SashaBrooke/OhPossum/README.md

# OhPossum
Hardware for the "OhPossum" possum deterrent system.
