SashaBrooke/OhPossum/models/raspi_desktop_jig/initial-drawing.PNG

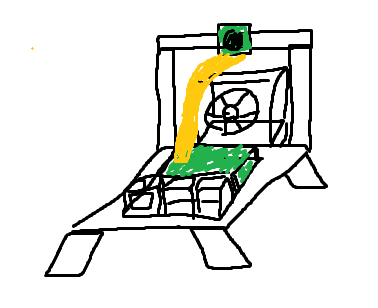
models/raspi_desktop_jig/initial-drawing.PNG
