SashaBrooke/OhPossum/models/motor_test_jig/motor_testing_assembly.rev1.SLDASM

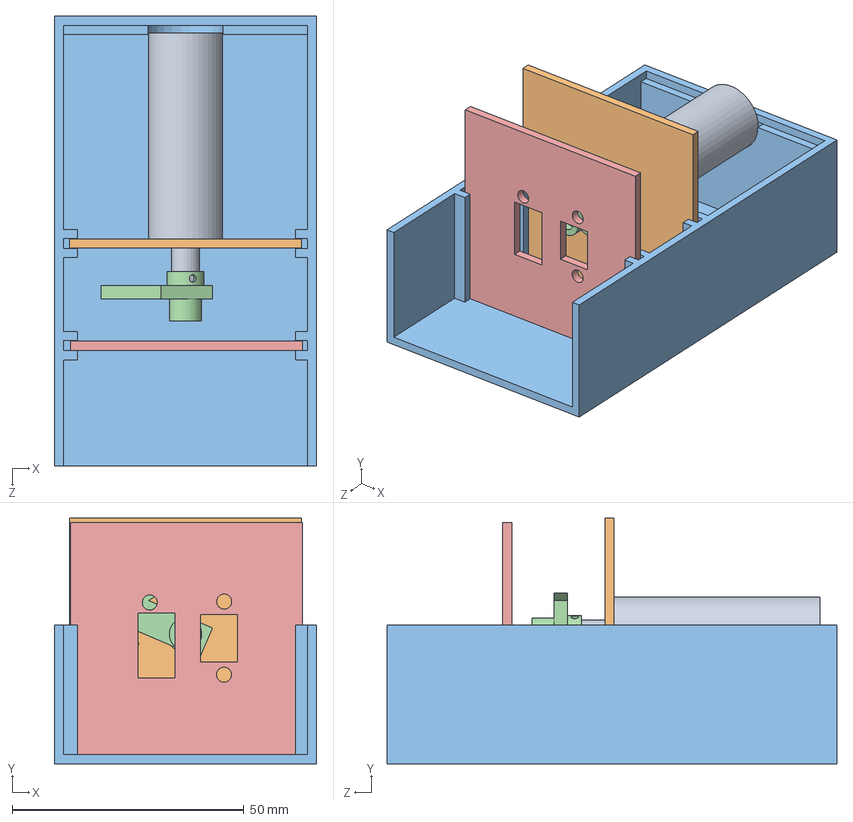
[picture p4: CAD file, 2025-03-11]
models/motor_test_jig/motor_testing_assembly.rev1.SLDASM
56.5 x 53.0 x 97.0 mm
Small Motor.rev1
Motor Mounting Plate.rev1
Motor Testing Base.rev1
Motor Testing Flag and Magnet Cap COMBO.rev3
Encoder Mounting Plate.rev2
