SashaBrooke/OhPossum/models/motor_test_jig/encoder_test_assem.rev2.SLDASM

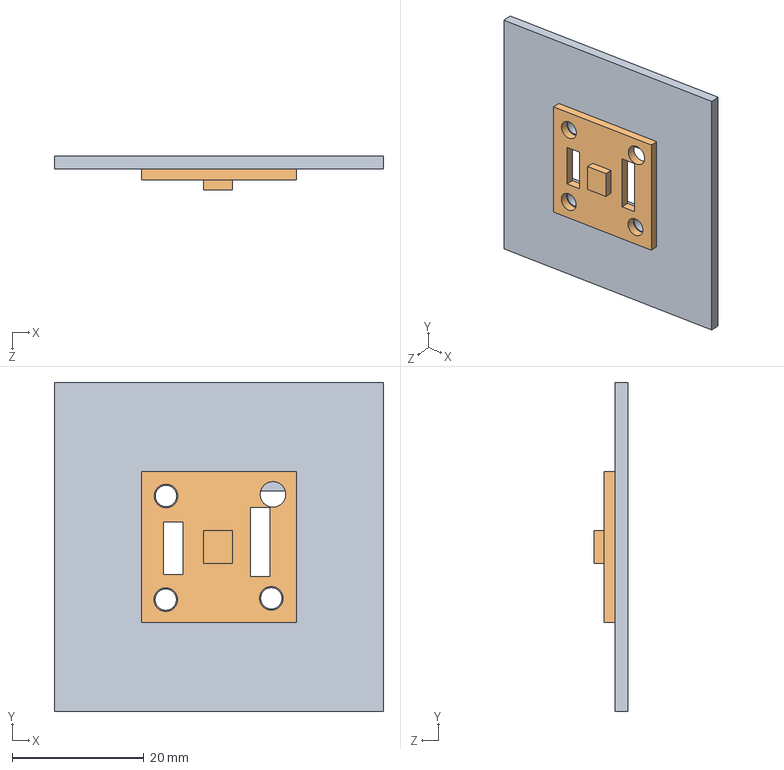
[picture p5: CAD file, 2025-03-11]
models/motor_test_jig/encoder_test_assem.rev2.SLDASM
50.0 x 50.0 x 5.20 mm
Encoder Mounting Plate.rev2
Ebay Encoder 1.rev1
