SashaBrooke/OhPossum/models/motor_test_jig/motor_mounting_plate.rev1.SLDPRT

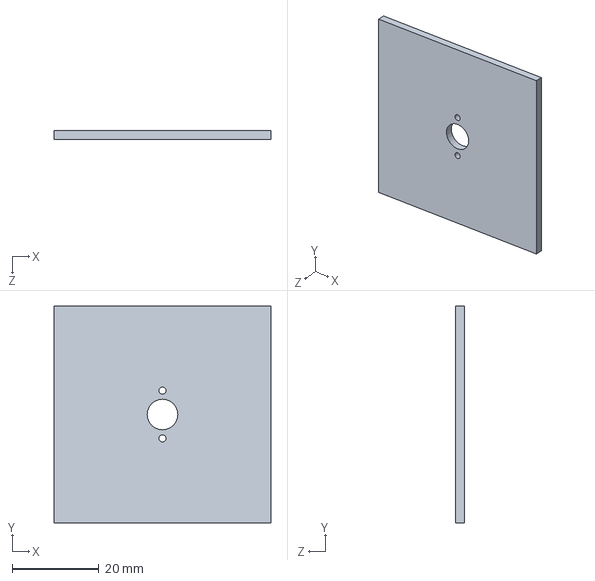
[picture p6: CAD file, 2025-03-11]
models/motor_test_jig/motor_mounting_plate.rev1.SLDPRT
50.0 x 50.0 x 2.00 mm
