SashaBrooke/OhPossum/models/motor_test_jig/motor_testing_base.rev1.SLDPRT

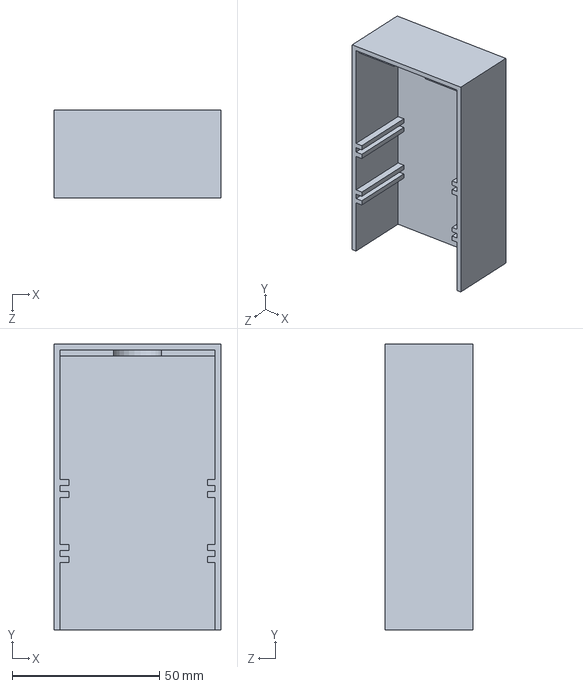
[picture p7: CAD file, 2025-03-11]
models/motor_test_jig/motor_testing_base.rev1.SLDPRT
56.5 x 97.0 x 30.0 mm
