SashaBrooke/OhPossum/models/prototype/v2/base.rev1.SLDPRT

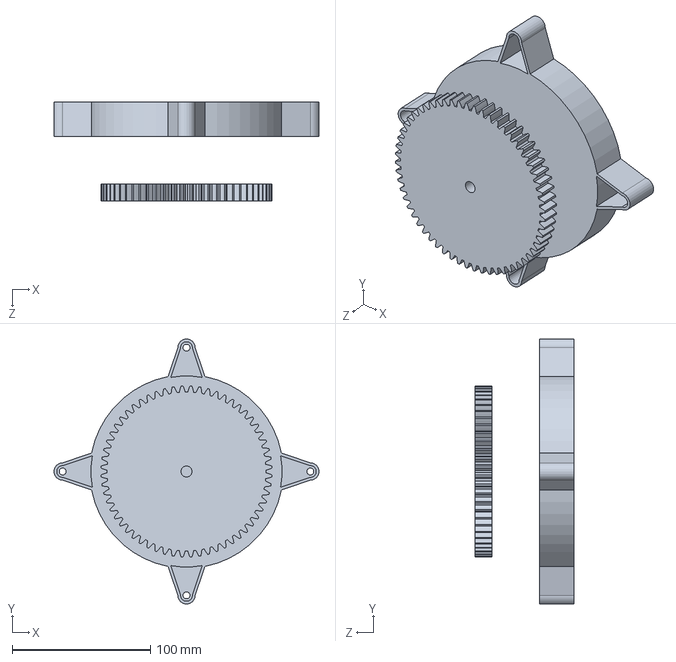
[picture p8: CAD file, 2025-03-11]
models/prototype/v2/base.rev1.SLDPRT
191.8 x 191.8 x 71.4 mm
