SashaBrooke/OhPossum/models/raspi_desktop_jig/raspberry_pi_desk_jig_model.SLDPRT

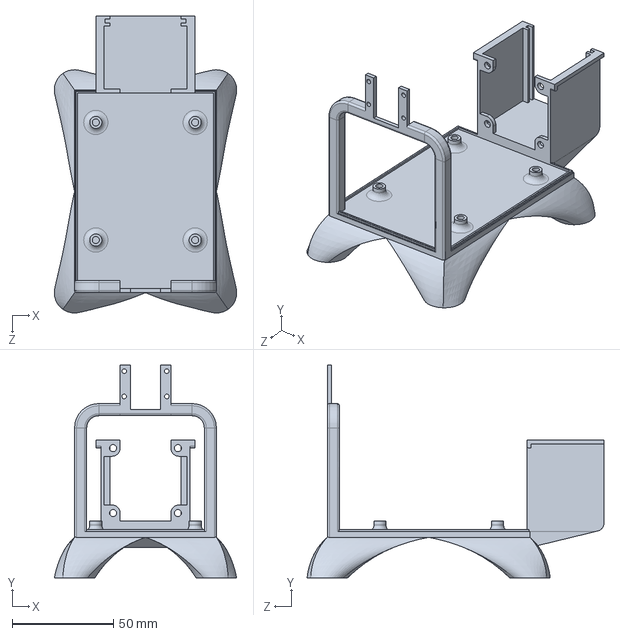
[picture p9: CAD file, 2025-05-20]
models/raspi_desktop_jig/raspberry_pi_desk_jig_model.SLDPRT
90.0 x 105.0 x 146.5 mm
