SashaBrooke/OhPossum/models/motor_test_jig/motor_testing_flag_and_magnet_cap_combo.rev3.SLDPRT

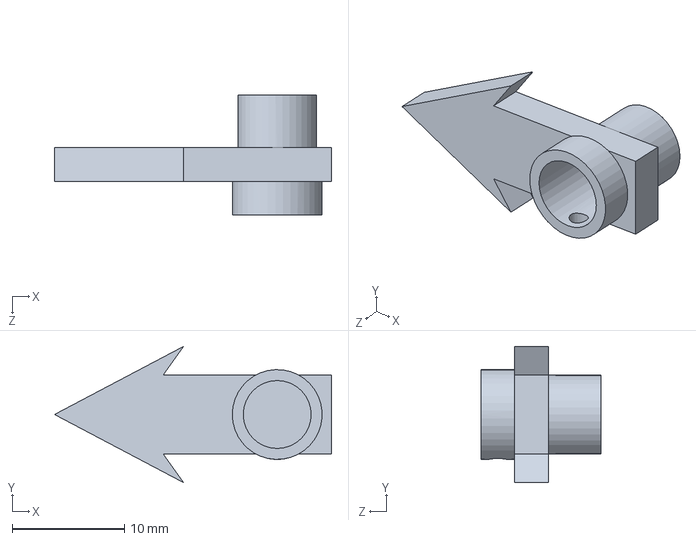
[picture p10: CAD file, 2025-03-11]
models/motor_test_jig/motor_testing_flag_and_magnet_cap_combo.rev3.SLDPRT
24.7 x 12.1 x 10.7 mm
