SashaBrooke/OhPossum/models/raspi_desktop_jig/mesh.SLDPRT

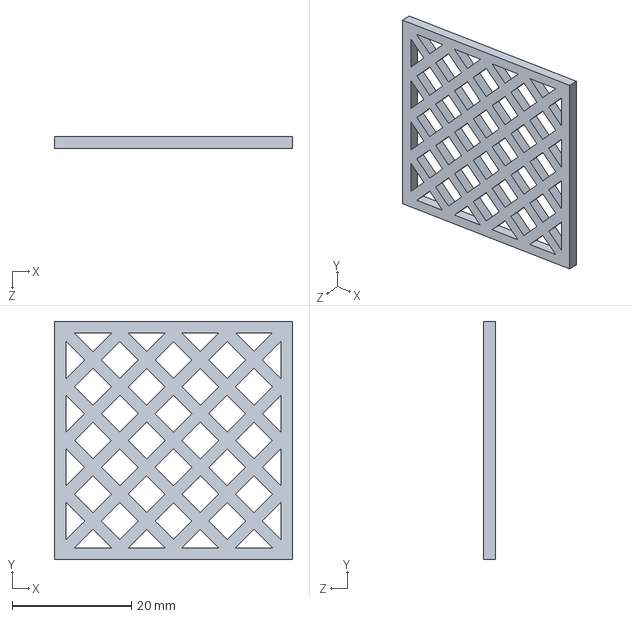
[picture p11: CAD file, 2025-05-20]
models/raspi_desktop_jig/mesh.SLDPRT
39.9 x 39.9 x 2.00 mm
