SashaBrooke/OhPossum/models/motor_test_jig/encoder_mounting_plate.rev2.SLDPRT

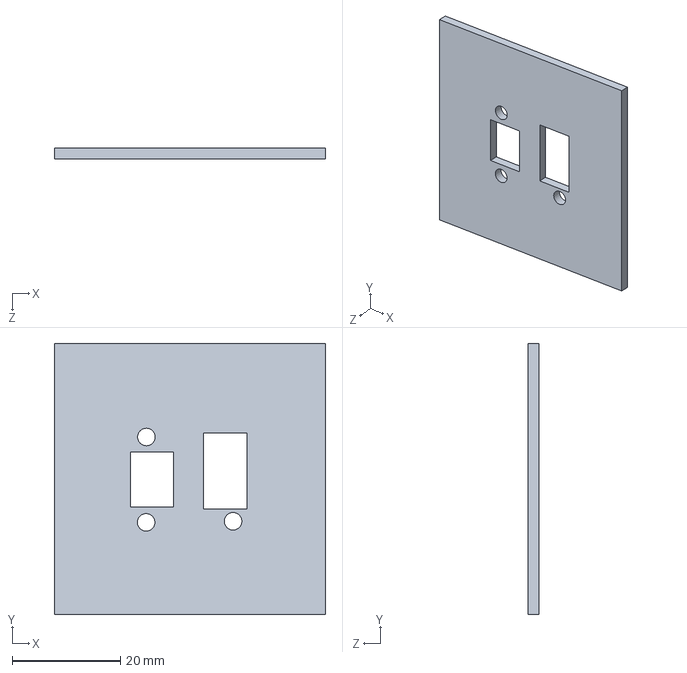
[picture p12: CAD file, 2025-03-11]
models/motor_test_jig/encoder_mounting_plate.rev2.SLDPRT
50.0 x 50.0 x 2.00 mm
