SashaBrooke/OhPossum/models/motor_test_jig/motor_testing_flag.rev2.SLDPRT

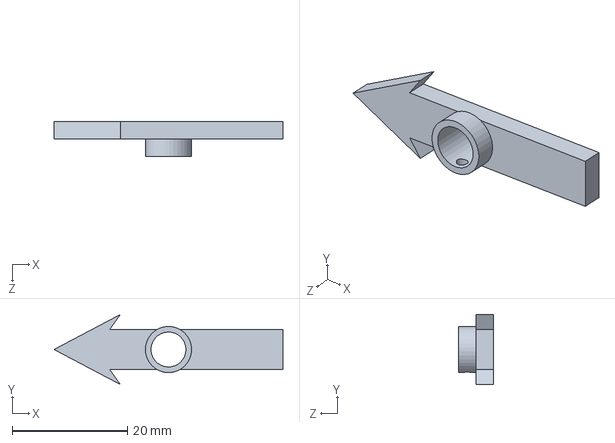
[picture p13: CAD file, 2025-03-11]
models/motor_test_jig/motor_testing_flag.rev2.SLDPRT
39.7 x 12.1 x 6.00 mm
