SashaBrooke/OhPossum/models/raspi_desktop_jig/roof.SLDPRT

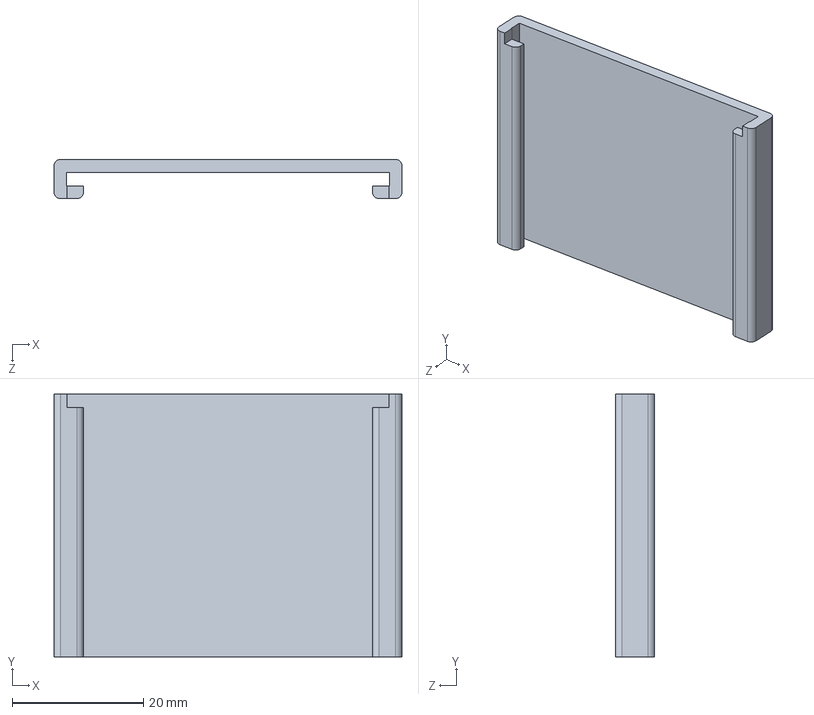
[picture p14: CAD file, 2025-05-20]
models/raspi_desktop_jig/roof.SLDPRT
53.0 x 40.0 x 6.00 mm
