SashaBrooke/OhPossum/models/raspi_desktop_jig/camera_module_3.step

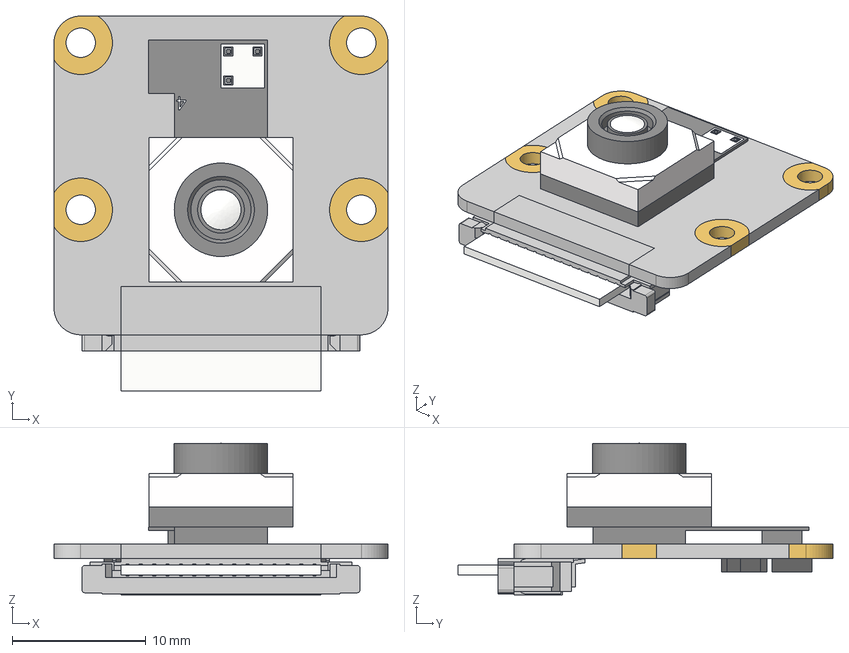
[picture p15: CAD file, 2025-05-20]
models/raspi_desktop_jig/camera_module_3.step
25.0 x 28.1 x 11.3 mm
Board
sfw15r3ste1lf
Sensor
Lens
Ring
Mount
Housing
