SashaBrooke/OhPossum/models/motor_test_jig/encoder_magnet_cap.rev1.SLDPRT

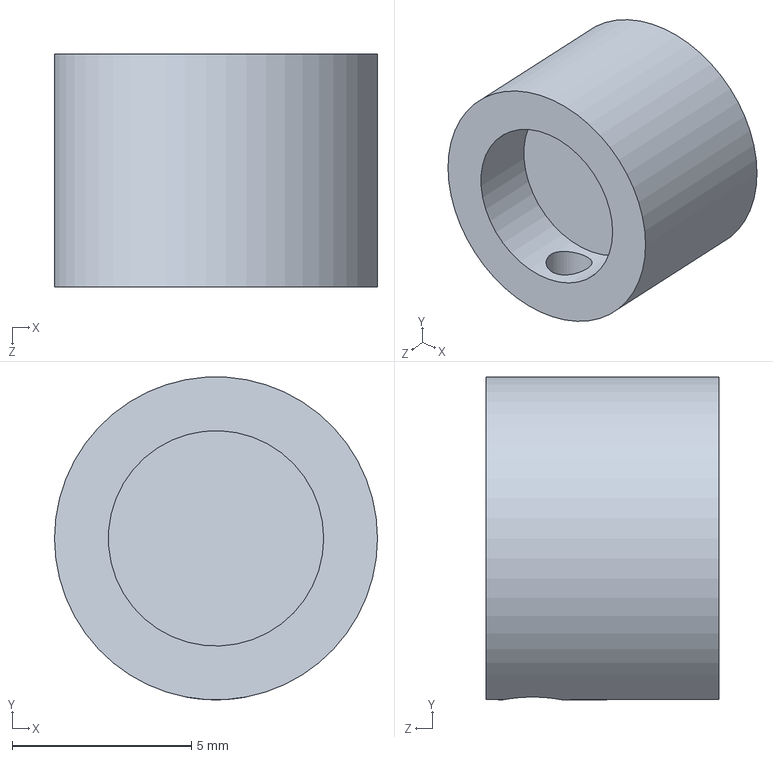
[picture p16: CAD file, 2025-03-11]
models/motor_test_jig/encoder_magnet_cap.rev1.SLDPRT
9.00 x 8.99 x 6.50 mm
