SashaBrooke/OhPossum/models/motor_test_jig/ebay_encoder_1.rev1.STEP

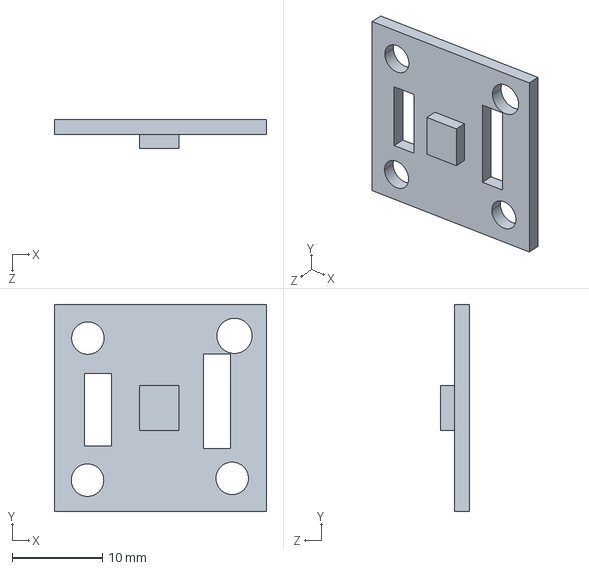
[picture p17: CAD file, 2025-03-11]
models/motor_test_jig/ebay_encoder_1.rev1.STEP
23.5 x 23.0 x 3.20 mm
