SashaBrooke/OhPossum/models/motor_test_jig/AS5600.step.SLDPRT

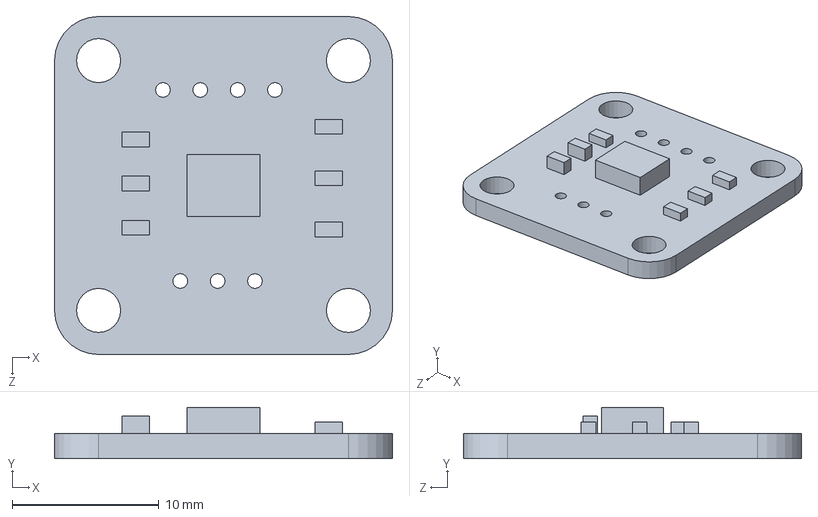
[picture p18: CAD file, 2025-03-11]
models/motor_test_jig/AS5600.step.SLDPRT
23.0 x 3.50 x 23.0 mm
