SashaBrooke/OhPossum/models/motor_test_jig/small_motor.rev1.SLDPRT

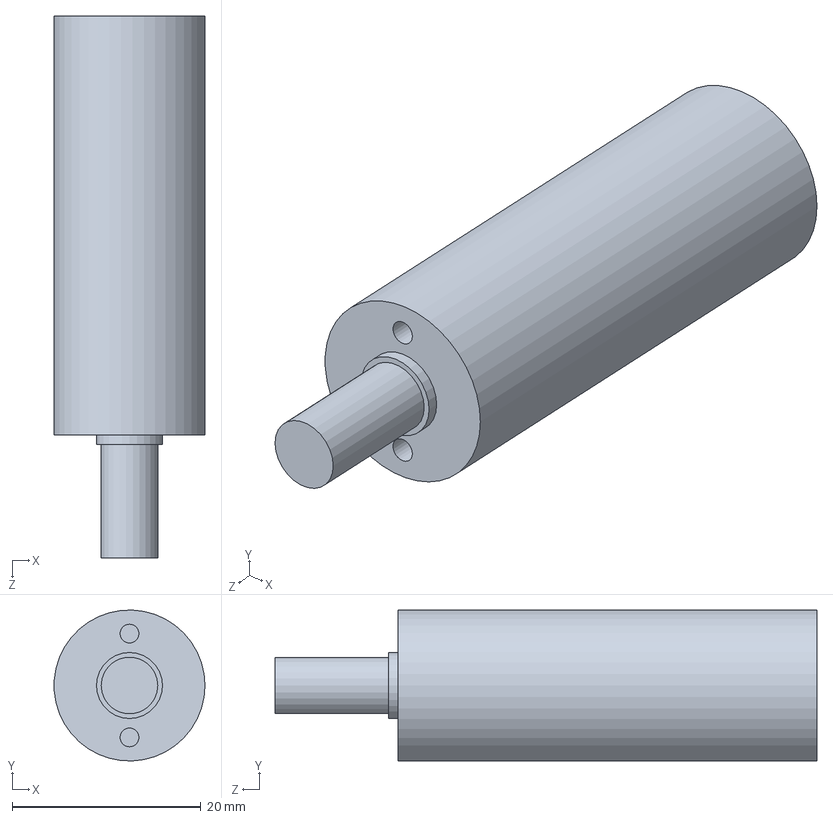
[picture p19: CAD file, 2025-03-11]
models/motor_test_jig/small_motor.rev1.SLDPRT
16.0 x 16.0 x 57.4 mm
