SashaBrooke/OhPossum/models/raspi_desktop_jig/raspberry_pi_desk_jig_model_assembly.SLDASM

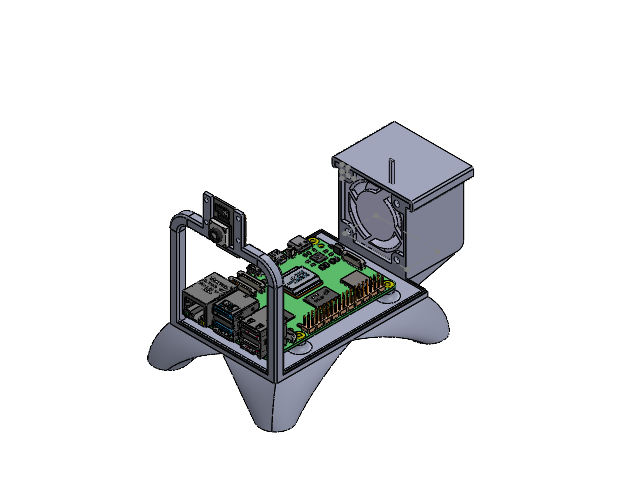
[picture p20: CAD file, 2026-07-25]
models/raspi_desktop_jig/raspberry_pi_desk_jig_model_assembly.SLDASM
Raspberry Pi Desk Jig Model
CARD_SLOT_METAL_PIN.STEP
SD_CARD_V1.STEP
PART3_V1.STEP
PLATE_RASPBERRY_PI_5.STEP
METAL_PLATE..STEP
GIGABIT_ETHERNET_PORT.STEP
2xUSB_3.0_PORT.STEP
2xUSB_2.0_PORT.STEP
FEMALE_MICRO_HDMI_CONNECTOR.STEP x 2
FEMALE_USB_CONNECTOR.STEP
STOCK_1.STEP
STOCK_2.STEP
STOCK_3.STEP
3.0_PIN_HEADER_10.STEP
2.0_PIN_HEADER.STEP
9FD77_D9WHV.STEP
GIGABIT_ETHERNET_TRANSCEIVER.STEP
RP1_CO_CONTROLLER.STEP
BROADCOM_1.STEP
MxL.STEP
CAMERA_DISPLAY_1.STEP
BUTTON_MINI.STEP
BUTTON_2.STEP
CONNECT_V1.STEP
CAMERA_DISPLAY_2.STEP x 2
Logo raspberry.STEP
sfw15r3ste1lf.step
Rear Components-0.step
Rear Components-1.step
Rear Components-2.step
Rear Components-3.step
Rear Components-4.step
Sensor.step
Lens.step
Ring.step
Mount.step
Housing.step
Board.step
eBom-FreeParts.step
04020VA
Roof
