SashaBrooke/OhPossum/(list of files, cad)

Other CAD files:
models/prototype/v2/small_motor.rev1.SLDPRT
models/prototype/v2/base_gear.rev1.SLDPRT
models/motor_test_jig/encoder_mounting_plate.SLDPRT
hardware/models/Single Axis Test Jig/6806ZZ v3.f3d
hardware/models/Single Axis Test Jig/AS5600 v1.f3d
hardware/models/Single Axis Test Jig/BottomPlate v12.f3d
hardware/models/Single Axis Test Jig/Drive gear v7.f3d
hardware/models/Single Axis Test Jig/Encoder magnet v1.f3d
hardware/models/Single Axis Test Jig/Initial axle design v10.f3d
hardware/models/Single Axis Test Jig/LMP-30A v1.f3d
hardware/models/Single Axis Test Jig/M2 x 0.4mm Thread 10mm LONG SOCKET HEAD CAP SCREW v1.f3d
hardware/models/Single Axis Test Jig/M2.5 Hex Screws (Various Lengths) v3.f3d
hardware/models/Single Axis Test Jig/M2.5x2mm Hex Nut v2.f3d
hardware/models/Single Axis Test Jig/M2.5x2mm Standoff v1.f3d
hardware/models/Single Axis Test Jig/M3 Cup Head Bolts（M3X6） v1.f3d
hardware/models/Single Axis Test Jig/M3 x 0.5mm Thread 18mm LONG SOCKET HEAD CAP SCREW v1.f3d
hardware/models/Single Axis Test Jig/M3x1.8mm Hex Nut v1.f3d
hardware/models/Single Axis Test Jig/Omron SS-5GL2 v2.f3d
hardware/models/Single Axis Test Jig/Small Motor v3.f3d
hardware/models/Single Axis Test Jig/Top bearing retainer v5.f3d
hardware/models/Single Axis Test Jig/TopPlate v11.f3d
models/motor_test_jig/ebay_encoder_1.rev1.SLDPRT
models/motor_test_jig/encoder_test_assem.rev1.SLDASM
models/motor_test_jig/motor_testing_flag.rev1.SLDPRT
models/motor_test_jig/printing_files/encoder_magnet_cap.rev1.STL
models/motor_test_jig/printing_files/encoder_mounting_plate.rev2.STL
models/motor_test_jig/printing_files/motor_mounting_plate.rev1.STL
models/motor_test_jig/printing_files/motor_testing_base.rev1.STL
models/motor_test_jig/printing_files/motor_testing_flag.rev2.STL
models/prototype/v1/aluminium_shaft.SLDPRT
models/prototype/v1/assembly.rev1.SLDPRT
models/prototype/v1/base.rev1.SLDPRT
models/prototype/v1/base.rev2.SLDPRT
models/prototype/v1/base_assembly.rev1.SLDASM
models/prototype/v1/base_gear.rev1.SLDPRT
models/prototype/v1/base_lid.rev1.SLDPRT
models/prototype/v1/cradle_base.rev1.SLDPRT
models/prototype/v1/hexalobular_socket_cheese_head_iso.SLDPRT
models/prototype/v1/pan_motor_mount.rev1.SLDPRT
models/prototype/v1/stand.rev1.SLDPRT
models/prototype/v1/upright.rev1.SLDPRT
models/raspi_desktop_jig/04020VA.sldprt
models/single_axis_test_jig/assembly/single_axis_test_jig.f3z
models/single_axis_test_jig/components_purchased/6806ZZ_v3.f3d
models/single_axis_test_jig/components_purchased/AS5600_v2.f3d
models/single_axis_test_jig/components_purchased/LMP-30A_v1.f3d
models/single_axis_test_jig/components_purchased/MKRVSR_motor_driver_v3.f3d
models/single_axis_test_jig/components_purchased/Omron_SS-5GL2_v2.f3d
models/single_axis_test_jig/components_purchased/Raspberry_Pi_Pico_R3_v3.f3d
models/single_axis_test_jig/components_purchased/archive/AS5600_ebay.f3d
models/single_axis_test_jig/components_purchased/encoder_magnet_v1.f3d
models/single_axis_test_jig/components_purchased/raspberry_pi_pico_mounting_board_v1.f3d
models/single_axis_test_jig/components_purchased/slip_ring_6.75Rx23.2Lmm_v1.f3d
models/single_axis_test_jig/components_purchased/small_motor_v4.f3d
models/single_axis_test_jig/components_to_manufacture/axle_v36.f3d
models/single_axis_test_jig/components_to_manufacture/bottom_plate_v16.f3d
models/single_axis_test_jig/components_to_manufacture/drive_gear_v7.f3d
models/single_axis_test_jig/components_to_manufacture/standoff_M2.5x2mm_v1.f3d
models/single_axis_test_jig/components_to_manufacture/top_bearing_retainer_v5.f3d
models/single_axis_test_jig/components_to_manufacture/top_plate_v28.f3d
models/single_axis_test_jig/edrawings_models/0603 Blue.iam
models/single_axis_test_jig/edrawings_models/1x6 Male Pin Header.iam
models/single_axis_test_jig/edrawings_models/6806ZZ Ball.ipt
models/single_axis_test_jig/edrawings_models/6806ZZ Inner ring.ipt
models/single_axis_test_jig/edrawings_models/6806ZZ Outer ring.ipt
models/single_axis_test_jig/edrawings_models/6806ZZ Shield.ipt
models/single_axis_test_jig/edrawings_models/6806ZZ v3.iam
models/single_axis_test_jig/edrawings_models/6806ZZ v3_1.iam
models/single_axis_test_jig/edrawings_models/AS5600 v2.ipt
models/single_axis_test_jig/edrawings_models/Arm.ipt
models/single_axis_test_jig/edrawings_models/Axle.ipt
models/single_axis_test_jig/edrawings_models/Body.ipt
models/single_axis_test_jig/edrawings_models/BottomPlate v15.iam
models/single_axis_test_jig/edrawings_models/COMPOUND (1).ipt
models/single_axis_test_jig/edrawings_models/COMPOUND (2).ipt
models/single_axis_test_jig/edrawings_models/COMPOUND (3).ipt
models/single_axis_test_jig/edrawings_models/COMPOUND (4).ipt
models/single_axis_test_jig/edrawings_models/COMPOUND (5).ipt
models/single_axis_test_jig/edrawings_models/COMPOUND.ipt
models/single_axis_test_jig/edrawings_models/Ceramic_Capacitor_0402_h20mil.iam
models/single_axis_test_jig/edrawings_models/D1, Diode, Schottky, Raspberry Pi Pico-R3.ipt
models/single_axis_test_jig/edrawings_models/D2, QSME-C194, LED, Raspberry Pi Pico-R3.ipt
models/single_axis_test_jig/edrawings_models/DG125-5.0-02P-14-00AH.iam
models/single_axis_test_jig/edrawings_models/DG125-5.0-02P-14-00AH_1.iam
models/single_axis_test_jig/edrawings_models/DG125-5.0-02P-14-00AH_2.iam
models/single_axis_test_jig/edrawings_models/EVM3ESX50Bxx-Panasonic.iam
models/single_axis_test_jig/edrawings_models/Initial axle design v31.ipt
models/single_axis_test_jig/edrawings_models/L1, Inductor, Raspberry Pi Pico-R3.ipt
models/single_axis_test_jig/edrawings_models/M2.5x14mm_cup_head_bolt v2.ipt
models/single_axis_test_jig/edrawings_models/M2.5x2mm_hex_nut v2.ipt
models/single_axis_test_jig/edrawings_models/M2x0.4mm_thread_10mm_long_socket_head_cap_screw v1.ipt
models/single_axis_test_jig/edrawings_models/M3x1.8mm_hex_nut v1.ipt
models/single_axis_test_jig/edrawings_models/M3x6mm_cup_head_bolt v1.ipt
models/single_axis_test_jig/edrawings_models/MKRVRS Motor Driver.iam
models/single_axis_test_jig/edrawings_models/MKRVSR_motor_driver v3.iam
models/single_axis_test_jig/edrawings_models/MicroUSB Port, Raspberry Pi Pico-R3.ipt
models/single_axis_test_jig/edrawings_models/Nichicon (UZG)(A) SQ(4.3) D(4) (L3.9).iam
models/single_axis_test_jig/edrawings_models/Omron_SS-5GL2 v2.iam
models/single_axis_test_jig/edrawings_models/Omron_SS-5GL2 v2_1.iam
models/single_axis_test_jig/edrawings_models/PCB, Raspberry Pi Pico-R3.ipt
models/single_axis_test_jig/edrawings_models/Part4.ipt
models/single_axis_test_jig/edrawings_models/Q1, MOSFET, DMG1012T, Raspberry Pi Pico-R3.ipt
models/single_axis_test_jig/edrawings_models/QFN-16 (4x4x0.9).iam
models/single_axis_test_jig/edrawings_models/RES0402.iam
models/single_axis_test_jig/edrawings_models/RES0402_1.iam
models/single_axis_test_jig/edrawings_models/RES0402_2.iam
models/single_axis_test_jig/edrawings_models/RES0402_3.iam
models/single_axis_test_jig/edrawings_models/RES0402_4.iam
models/single_axis_test_jig/edrawings_models/RES0402_5.iam
models/single_axis_test_jig/edrawings_models/RES0402_6.iam
models/single_axis_test_jig/edrawings_models/RES0402_7.iam
models/single_axis_test_jig/edrawings_models/RP2040 Microcontroller, Raspberry Pi Pico-R3.ipt
models/single_axis_test_jig/edrawings_models/Raspberry_Pi_Pico_R3 v3.iam
models/single_axis_test_jig/edrawings_models/SMD Capacitor, Configurable, Raspberry Pi Pico-R3_C1.ipt
models/single_axis_test_jig/edrawings_models/SMD Capacitor, Configurable, Raspberry Pi Pico-R3_C10.ipt
models/single_axis_test_jig/edrawings_models/SMD Capacitor, Configurable, Raspberry Pi Pico-R3_C11.ipt
models/single_axis_test_jig/edrawings_models/SMD Capacitor, Configurable, Raspberry Pi Pico-R3_C12.ipt
models/single_axis_test_jig/edrawings_models/SMD Capacitor, Configurable, Raspberry Pi Pico-R3_C13.ipt
models/single_axis_test_jig/edrawings_models/SMD Capacitor, Configurable, Raspberry Pi Pico-R3_C14.ipt
models/single_axis_test_jig/edrawings_models/SMD Capacitor, Configurable, Raspberry Pi Pico-R3_C15.ipt
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
