SashaBrooke/OhPossum/printed_hole_size_dictionary.xlsx

Intended hole size (mm): | Pre-print hole size: | Printed hole size (mm): | Alt hole size (mm): |  | Error (mm): | Alt error: | Avg error: | Holes we want :) | Holes we get… | What joe (this guy…) thinks: | What we gonna do! | Rad
41 | 42.4 | 41.6 | 42.2 | *sanded | 0.8 | 0.2 | 0.5 | 41 | 41.63819704 | 41.5 | 41.6 | 20.8
36 | 36 | 35.6 | 35.4 |  | 0.4 | 0.6 | 0.5 | 36 | 36.5963497 | 36.5 | 36.6 | 18.3
7 | 7 | 6.63 | 6.75 |  | 0.37 | 0.25 | 0.31 | 7 | 7.353635172 | 7.31 | 7.4 | 3.7
4 | 4.3 | 3.9 | 3.88 | *crooked top layer | 0.4 | 0.42 | 0.41 | 4 | 4.328526772 | 4.41 | 4.4 | 2.2
3 | 3 | 2.65 | 2.6 |  | 0.35 | 0.4 | 0.375 | 3 | 3.320157306 | 3.375 | 3.4 | 1.7
2.5 | 2.5 | 2.18 | 2.16 |  | 0.32 | 0.34 | 0.33 | 2.5 | 2.815972572 | 2.83 | 2.8 | 1.4
2.5 | 2.5 | 2.28 | 2.35 | (slotted) | 0.22 | 0.15 | 0.185 | 2 | 2.311787839 | 2.185 | 2.3 | 1.15
2 | 2 | 1.51 | 1.7 |  | 0.49 | 0.3 | 0.395 | 2.9 | 3.219320359 | 3.295 | 3.3 | 1.65
 |  |  |  |  |  |  |  | 4.4 | 4.731874559 | 4.4 | 4.7 | 2.35
 |  |  |  |  |  |  |  | 8 | 8.362004638 | 8 | 8.4 | 4.2
