SashaBrooke/OhPossum/(threads)

Thread 2 (2025-01-09):

Encoder Offset Functionality

SashaBrooke, 2025-01-09:
## Encoder Offset Setting Feature
Need to implement a way to zero the encoder during gimbal operation. This will likely be a function in the (AS5600 library)(https://github.com/SashaBrooke/OhPossum/blob/control-system/software/pico/src/as5600.c).

## Usage
Would likely be performed automatically on gimbal startup (using hard-stops or switches to zero).

Example usage:
```
for (each axis) {
    while (not at hardstop) {
        small increment in direction of hardstop;
    }

    // Once at hardstop
    AS5600_setOffset(offset)
}
```

Unlikely to be support setting offset manually through serial command interface (could result in dangerous behaviour such as overrunning gimbal soft-limits).

SashaBrooke, 2025-01-20:
On powerup. if held in the same orientation through multiple power cycles, the AS5600 encoder seems to read the same value each time. May not need an offset, instead could set soft limits manually relative to initial starting position (wouldn't need limit switches).

SashaBrooke, 2025-01-20:
Could be more safe to perform automatic homing anyway in case of mechanical changes between power cycles (e.g. encoder magnet slips slightly).

SashaBrooke, 2025-01-20:
**Possible implementation:**
```
// Find pan lower limit and set zero position
bool atPanLowerLimit = false;
while (!atPanLowerLimit) {
    atPanLowerLimit = !gpio_get(PAN_LOWER_LIMIT_PIN); // Pulled high default (therefore !)

    if (atPanLowerLimit) {
        uint16_t lowerLimit = AS5600_getRawAngle(&gimbal->panEncoder);
        gimbal->panEncoder.offset = lowerLimit;
        break;
    } else {
        gimbal->panPositionSetpoint -= HOMING_SPEED;
    }
}
```
(refer to commits related to #9)

Thread 3 (2025-01-10):

PID Parameter Modification

SashaBrooke, 2025-01-10:
**Feature Description:**
Want the ability to modify PID parameters during gimbal runtime (instead of having to power cycle and directly update hardcoded values).

**Usage:**
Could be incorporated into serial command interface, exposing PID parameters to modification during user operation of the gimbal. Command interface has access to gimbal settings and configuration and would be able to save modifications to persist between power cycles if improvements to gimbal tuning were made.

Example usage:
User calls `pan-pid-kp=0.2` (example command name) to change the pan proportional gain (to 0.2).

Internally in the [command interface](https://github.com/SashaBrooke/OhPossum/blob/control-system/software/pico/src/command.c), `executeCommand()`, something like...
```
if (command == pan-pid-kp) {
    // Validate input value

    panPositionController.Kp = value
}
```

**Note:** Changes made should affect runtime settings but should require configuration save to persist between power cycles.

Thread 4 (2025-01-10):

Single axis test jig

SashaBrooke, 2025-01-10:
**Hardware Request:**
Need a simple single axis jig to test system performance.

**Basic Requirements:**
- One-degree of freedom/rotation
- Incorporate same maxon brushless DC motor and AS5600 magnetic encoder as the [motor test jig](https://github.com/SashaBrooke/OhPossum/tree/hardware/hardware/models/Motor%20Test%20Jig)
- Be expandable for development of additional axes

SashaBrooke, 2025-01-24:
**Example sketch:**
<kbd>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</kbd>

SashaBrooke, 2025-01-24:
**Interface between base plate and top plate:**
<kbd>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</kbd>

SashaBrooke, 2025-01-28:
> **Example sketch:** 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

Red block in the middle of the sketch (on the left) is a physical hardstop which should be mirrored on the opposite side (giving 180 degrees of rotation). The green block is an electrical switch used for the software homing and software limits setting process.

SashaBrooke, 2025-01-28:
> **Interface between base plate and top plate:** 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

Make the axel shaft out of two separate halves (would allow a slipring to be inserted easier). The halves would be held together by the two bearings and by threading into the base plate.

SashaBrooke, 2025-03-11:
First version released in #44

Closed 2025-03-11.

Thread 6 (2025-01-10):

Single Axis Prototype Testing

SashaBrooke, 2025-01-10:
**Overview:**
Need to test the single axis prototype functions as expected.

**Test Plan:**
Hardware:
- Unpowered rotation of single axis (full range of motion)
- Unpowered backlash check (if applicable)

Software:
- Unit tests for each module/library
- System tests for each supported gimbal control command
- Critical system functionality tests for position determination and armed position demand/hold

SashaBrooke, 2025-03-01:
Software testing can be reduced to overall system level testing for the single axis prototype

Thread 7 (2025-01-10):

Gimbal Control Command Refactor

SashaBrooke, 2025-01-10:
**Feature Description:**
Modularise gimbal control commands into separate functions to aid ease of testing.

**Usage:**
Instead of chained if-else stataments each containing a separate command implementation, these would be split into separate functions.

For example...
```
if (command == exampleCommand) {
    // Get value in specific format for this command

    // Validate value

    // Update something
}
```
Could be converted into something like...
```
if (command == exampleCommand) {
    // Get value in specific format for this command

    exampleCommand(value); // validation and update done in function
}
```

SashaBrooke, 2025-01-13:
Lots of duplicate code introduced in 6fa6f35 could benefit from this refactor.

SashaBrooke, 2025-01-20:
**Suggestion:**
Separate into two files, serial_comm.c and command.c

Communication module handles serial input and parsing (including for commands).
Command module handles the actual execution of commands.

SashaBrooke, 2025-01-20:
Get the command name and value for every command input (both can be null for invalid input). These are the input the command function where they are checked for suitability for that particular command (e.g. for commands expecting boolean values the value should be 0 or 1). Value would be parsed as a float (generic case) and then checked to see if it could be converted into the expected data type (e.g. floor(0.1) == 0.1 would reveal that 0.1 is not a valid integer input).

SashaBrooke, 2025-01-21:
Add utility functions: `parseInt()`, `parseFloat()` (maybe `parseEnum()` although probably just use `parseInt()`).

Move each command into its own function and pass the raw command string.

Let the command function do its own error checking (for parsed values).

Add function pointers to the list of available commands (perhaps as a comand mapping with included descriptions).
```
command_t availableCommands[] = {
    {"example-command", exampleCommand(), "Example command does this."},
    // more...
};
```

Loop through all available commands and if the input command has the same name as the name of the command being checked against, execute its command function.
```
for (int i = 0; i < numAvailableCommands; i++) {
    if (strcmp(inputCommandName, availableCommands[i].name) == 0) {
        availableCommands[i].commandFunction();
        return;
    }
}

// Or command not found...
```

SashaBrooke, 2025-01-21:
Or include an expected value data type in the command mappings and parse before calling the command function (probably better for testing).

SashaBrooke, 2025-01-21:
Could be useful to have return error codes for different cases instead of or as well as outputting error messages.

This could be done with a `command_error_t` enum with cases for things like:
- `COMMAND_ERROR_DOESNT_EXIST` (entering an invalid command)
- `COMMAND_ERROR_INVALID_VALUE_DATA_TYPE` (entering the wrong value data type)
- `COMMAND_ERROR_NOT_ALLOWED` (gimbal not allowed to execute that command currently, e.g. arming without soft limits set)
- etc...

SashaBrooke, 2025-01-22:
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

Could parse a float value (if value is present) and use this as input in every command function that expects a value. This could then be error checked and if valid, cast to the correct type.

Thread 10 (2025-01-12):

Command Shortcut Versions

SashaBrooke, 2025-01-12:
**Feature Description:**
Have shortened or acronym versions of each command (or important/frequently used commands).

**Usage:**
Using serial input, enter:
- `gr` instead of `gimbal-read`
- `arm` instead of `gimbal-arm`
- `gsr=1` instead of `gimbal-streamrate=1`

**Possible implementation:**
Would only require one extra check when comparing an input commands string to possible supported command names.
```
    --- current check ---
if (command == longVersion OR command == shortVersion) {
    // Do command
}
```

Thread 11 (2025-01-13):

Packet/package streaming capability

SashaBrooke, 2025-01-13:
**Feature Description:**
Could be useful to give the user the ability to choose the types of information they stream from the gimbal. For example, maybe the user only wants to stream position data (encoder values), or PID output, or PID parameters, etc.

Could also want a `gimbal-list-streams` command to tell the user what they are streaming if they forget.

**Usage:**
The user could manipulate the 'packets' they want to stream using the serial command interface.
E.g. `gimbal-stream-encoder`, `gimbal-stream-pid-out`, `gimbal-stream-pid-params`

**Possible Implementation:**
Have flags for whether each packet is streaming or not whilst keeping the original print flag (modified with `gimbal-stream`).
```
// During printing to serial output
if (overallPrintFlag) {
    // Append chosen packets
    if (specificStreamFlag1) {
        printf("%d,%d", info1, info2);
    }
    if (specificStreamFlag2) {
        printf("%d,%d", info3, info4);
    }
    // etc...

    // Add newline right at the end after all packets have been appended to the stream output
    printf("\n);
}
```

SashaBrooke, 2025-01-14:
Could add a recalculation of the proportional component of the PID controller to the PID stream packet. Something like `printf("%f", gimbal.panPositionController.Kp * gimbal.panPositionController.prevError);`

Closed 2025-01-20.

Thread 13 (2025-01-14):

Provide support for (maybe migrate to) UART command input

SashaBrooke, 2025-01-14:
**Feature Description:**
Add support for UART command input in preparation for more refined system prototype versions where the Raspberry Pi Pico USB port is not available (e.g. space constraints / sliprings).

May even want to migrate to solely use/support UART communication for prototype versions after the single axis version.

**Possible Implementation:**
Not sure, but may be as simple as setting the Pico to use UART instead of USB for serial communication and using an FTDI device/adapter to interface with the controlling computer.

**Resources:**
[UART communication on Raspberry Pi Pico using FTDI cable](https://www.youtube.com/watch?v=pbWhoJdYA1s)
[UART communication using HW-417 (USB to TTL converter)](https://www.youtube.com/watch?v=7yhgYJe2ShM)
[UART communication between two Raspberry Pi Picos](https://www.youtube.com/watch?v=kN2jCOF8zYc) (MicroPython but may still be useful)

Thread 14 (2025-01-21):

System testing framework

SashaBrooke, 2025-01-21:
**Feature request:**
A program that allows different system tests to be run (either manually with supervision or automated).

**Usage:**
- Select movement test / PID evaluation test
- Runs a test that sends out commands to the gimbal telling it to move to different positions and measuring the error (currentPos vs setPointPos) during its movement.
- Reports results of test

**Integration:**
Could be a simple command line program where the tests you want to run are entered based on their number (or something similar).

Could also be integrated with a GUI control program (e.g. OhPossumGimbalControl) for visual reporting and easier interface.

Example:
<kbd>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</kbd>

SashaBrooke, 2025-01-21:
Might be able to use something like this (depending on speed and peripheral support):
[Wokwi Raspberry Pi Pico Simulator](https://wokwi.com/pi-pico)
[Example simulation (using the C/C++ SDK)](https://wokwi.com/projects/381259034288167937)

Thread 18 (2025-01-21):

Control system unit testing framework

SashaBrooke, 2025-01-21:
**Feature request:**
Investigate unit testing frameworks for an embedded system.

**Resources:**
Normal unit testing frameworks:
[Unity](https://github.com/ThrowTheSwitch/Unity)
[GoogleTest](https://github.com/google/googletest)

Could also use a simulator to individually test hardware library modules.
[Wokwi Raspberry Pi Pico Simulator](https://wokwi.com/pi-pico)
[Example simulation (using the C/C++ SDK)](https://wokwi.com/projects/381259034288167937)

SashaBrooke, 2025-03-01:
Will invest time into this at a later but not critical for first prototype release

Thread 22 (2025-01-23):

Gimbal state refactor

SashaBrooke, 2025-01-23:
**Fix wanted:**
Put stream variables as struct members in the gimbal state. This will allow them to be passed to commands. In particular, when disarming, the motor output and direction need to be reset to default (nothing). At the moment this is has been hacked together by modifying the stream variables in the controls loop. Can decide whether this is satisfactory or not.

SashaBrooke, 2025-01-26:
Clarification: these stream variables are those related to mode changes (e.g. motor out needs to be reset when changing to free mode).

Thread 24 (2025-01-23):

Soft axis upper limit not setting on full revolution

SashaBrooke, 2025-01-23:
**Bug description:**
Control system is supposed to set the upper soft limit if the axis makes a full revolution (back to the lower limit). This is not the case, the motor keeps spinning around and never auto-stops / sets the upper limit until the limit switch is closed.

SashaBrooke, 2025-01-28:
Not relevant/required for single axis implementation test

SashaBrooke, 2025-02-05:
May want to change from `SENTINEL` to use `SOFT_LIMITS_NEVER_SET` (or `NEVER_SET`) and `SOFT_LIMITS_OVERRIDEN` (or `OVERRIDEN`).
This would bypass any arm warnings for unset soft limits when using sliprings.

Thread 25 (2025-01-23):

Axis soft limits setting timeout

SashaBrooke, 2025-01-23:
**Feature description:**
Could be a useful feature to have a timeout so that if the process of setting the soft limits is taking too long (likely case if stuck in infinite loop / bug), the gimbal is able to transition into 'normal' operation. However, in this case the soft limits would never have been set and the gimbal would not be able to arm. This case should be caught by the safety checks already put in place in 8cb19ad.

SashaBrooke, 2025-01-23:
Could be simple to check if a full revolution has been done (when setting lower limit) but this wouldn't catch the case where something stalls due to a bug.

Thread 27 (2025-01-28):

Modularise soft limit setting

SashaBrooke, 2025-01-28:
**Feature description:**
Have a common function that finds and sets a soft limit. Provide the axis limit pin, the increment (+-HOMING_SPEED), the operation start time. Before calling any function, get the start time and start position, then can move to the midpoint after limits are set.

**Possible implementation:**
```
/* Function */
bool setSoftLimit(int AXIS_LIMIT_PIN, int INCREMENT, uint64_t startTime) {
    // Set limit
    // Return true or false
}

/* In main */
uint64_t startTime = time_us_64();
uint16_t startPos = pos; // Stream variable

if (setSoftLimit(PAN_LOWER_LIMIT_PIN, -HOMING_SPEED, startTime) && setSoftLimit(PAN_UPPER_LIMIT_PIN, HOMING_SPEED, startTime)) {
    uint16_t endPos = pos; // Stream variable
    uint16_t midpoint = XXX; // Midpoint logic

    // Move to midpoint
    // Disarm (end soft limit setting procedure (maybe success message)
}
```

SashaBrooke, 2025-01-28:
Also pass max rotation (for timeouts). E.g. for first limit full rotation allowed before timeout, for second limit only rotation until at first limit is allowed.

SashaBrooke, 2025-01-28:
Related commit (83cc9ce)

Thread 28 (2025-01-29):

PID error calculation doesn't care about soft limits

SashaBrooke, 2025-01-29:
**Bug description:**
The PID error is currently calculated so that it will take the fastest route to the target. However, this ignores the soft limits. If the fastest way to reach the setpoint means going towards (and attempting to move past) a soft limit this is allowed (should not be).

**Possible solution:**
Perform the soft limit setting operation on the first arm (if soft limits are `SENTINEL`) or on every arm.

Have a 360 setting (that allows soft limits being unset) - e.g. if a slipring is being used.
OR
Just ignore this issue and assume that a slipring is being used.

SashaBrooke, 2025-02-05:
Rotary utilities library implemented in private repository. Can close when tested in system.

SashaBrooke, 2025-02-05:
May want to change from `SENTINEL` to use `SOFT_LIMITS_NEVER_SET` (or `NEVER_SET`) and `SOFT_LIMITS_OVERRIDEN` (or `OVERRIDEN`).
This would bypass any arm warnings for unset soft limits when using sliprings.

Closed 2025-03-02.

Thread 30 (2025-02-04):

Incorrect PID error calculation

SashaBrooke, 2025-02-04:
**Bug description:**
PID error calculation is incorrect. Developing unit tests for a modular rotary error calculator revealed that the error is often off by `1.0f` due to using the max raw angle measurement of the AS5600 encoder instead of a resolution (`4096`).

**Possible solution:**
Change `AS5600_ANGLE_MIN/MAX` (or whatever it is) to `AS5600_RESOLUTION 4096` and use this in the PID error calculation.

May also want to change the PID struct member `maxMeasurement` to `angularResolution`.

**Test log:**
```
------- STARTING TESTS -------
Test failed: Forward wrap-around
Measurement=4000.0, Setpoint=100.0, MaxMeasurement=4095.0, LowerLimit=VALUE_NOT_PRESENT, UpperLimit=VALUE_NOT_PRESENT. Expected error=196.0, Actual error=195.0.
Test failed: Reverse wrap-around
Measurement=100.0, Setpoint=4000.0, MaxMeasurement=4095.0, LowerLimit=VALUE_NOT_PRESENT, UpperLimit=VALUE_NOT_PRESENT. Expected error=-196.0, Actual error=-195.0.
Test failed: Equal error case
Measurement=100.0, Setpoint=2148.0, MaxMeasurement=4095.0, LowerLimit=VALUE_NOT_PRESENT, UpperLimit=VALUE_NOT_PRESENT. Expected error=2048.0, Actual error=-2047.0.
Test failed: Edge case at max boundary
Measurement=4095.0, Setpoint=0.0, MaxMeasurement=4095.0, LowerLimit=VALUE_NOT_PRESENT, UpperLimit=VALUE_NOT_PRESENT. Expected error=1.0, Actual error=0.0.
Measurement=1000.0, Setpoint=400.0, MaxMeasurement=4095.0, LowerLimit=500.0, UpperLimit=3500.0. Expected error=0.0, Actual error=3495.0.
Measurement=1000.0, Setpoint=3600.0, MaxMeasurement=4095.0, LowerLimit=500.0, UpperLimit=3500.0. Expected error=0.0, Actual error=2600.0.
Test failed: Wrap-around case with limits
Measurement=3500.0, Setpoint=500.0, MaxMeasurement=4095.0, LowerLimit=3000.0, UpperLimit=1000.0. Expected error=1096.0, Actual error=1095.0.
Test failed: Edge case at max boundary
Measurement=4095.0, Setpoint=0.0, MaxMeasurement=4095.0, LowerLimit=3500.0, UpperLimit=1000.0. Expected error=1.0, Actual error=0.0.

-------- TEST SUMMARY --------
WARNING: Not all tests passed!
```

SashaBrooke, 2025-02-05:
Resolved in rotary utilities library (private repository). Can close when test in system.

Closed 2025-03-02.

Thread 31 (2025-02-08):

Bearing model rigid instead of rotating motion

SashaBrooke, 2025-02-08:
**Hardware issue description:**
6806ZZ bearing is modeled as a rigid body (as of commit 24462b0) and therefore does not demonstrate the correct bearing rotation joint.

**Possible solution:**
May not need to be fixed - can just create a revolute join that allows sliding when connecting the top plate to the bearings.
OR
Will need to model the bearing with each individual ball and race with different joints (perhaps a lot of unnecessary work if simulations are not in the scope of the project).

Resource for 2nd option (if chosen):
[Applying & Animating Joints of Bearing in Fusion 360](https://www.youtube.com/watch?v=7IAN-klyhZU)

SashaBrooke, 2025-02-08:
Tested method 1: Did not seem to work

May need to investigate method 2 if simulation is important.

SashaBrooke, 2025-02-17:
Not considered important for single axis test jig

Closed 2025-03-01.

Thread 32 (2025-02-13):

Begin 3D printing for single axis jig

SashaBrooke, 2025-02-13:
**Hardware request description:**
Begin 3D printing of parts for the single axis test jig once face offsets have been given sufficient tolerances for assembly.

**Note:**
Any modelled parts that fit together (not off-the-shelf) should have an offset applied for a tight but removable fit.

SashaBrooke, 2025-03-01:
IT HAS BEGUN!!

Closed 2025-03-01.

Thread 33 (2025-02-14):

Motor fastener holes not deep enough

SashaBrooke, 2025-02-14:
**Hardware fix description:**
Need to edit the model of the small Maxon DC motor to make the fastener holes the correct depth. May be able to consult product data sheet.

SashaBrooke, 2025-02-21:
Changed to 8mm. May not be entirely accurate to the real motor but good enough for the 10mm fasteners being used (8mm mounting hole + 2mm mounting plate = 10mm fastener length).

Closed 2025-02-21.

Thread 34 (2025-02-15):

Move motor mounting holes on single axis jig

SashaBrooke, 2025-02-15:
**Hardware issue description:**
Might be good design to move the motor mounting holes for the small Maxon DC motor to a side (from front facing) that means it lies below a potential site of a cradle sidearm. This would make the single axis jig easier to extend into the full two axis version.

SashaBrooke, 2025-04-27:
This will be done in a separate future refactor.

Closed 2025-04-27.

Thread 35 (2025-02-22):

Include limit switch system in single axis prototype

SashaBrooke, 2025-02-22:
**Hardware issue description:**
Need to include the limit switches in the final design for the single axis prototype. Will need to figure out a good was of allowing for the required 180 degrees of rotation.

**Possible implementation:**
Have the switches mounted under the top plate nearby the drive gear. When the top plate is driven clockwise or counter-clockwise 90 degrees (to the upper or lower limit), the switch will collide with a tab printed into the bottom plate (offset 90 degrees from the initial home position of the tabs respective limit switch).

SashaBrooke, 2025-02-22:
<kbd>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</kbd>
Green = upper limit, red = lower limit

Closed 2025-03-04.

Thread 36 (2025-02-24):

Single axis jig components sharp edge fillets

SashaBrooke, 2025-02-24:
**Hardware issue description:**
Sanji recommends adding fillets to components in the single axis test jig that have sharp edges. This will help strengthen the print (e.g. the overhang magnet cap in the axle shaft component). Should also make it look a bit nicer.

Closed 2025-03-11.

Thread 38 (2025-02-27):

Only set soft limits if homing completes

SashaBrooke, 2025-02-27:
**Bug description:**
Soft limits should only change from the `SENTINEL` if the homing process completes. Currently if the limit switches are hit but the gimbal doesn't reach the midpoint before the timeout, the limits are set but the homing process technically has not been completed (might lead to unwanted behaviour).

**Possible solution:**
Store the limits as temporary variables and only set them once the midpoint is reached.

Closed 2025-03-01.

Thread 39 (2025-02-28):

Standoffs/washers for limit switches to lower plane

SashaBrooke, 2025-02-28:
**Hardware issue description:**
May need to include standoffs or washers when mounting the limit switches on the single axis jig so that the switch contacts are in the same plane as the hard stop tabs on the bottom plate.

Closed 2025-03-04.

Thread 42 (2025-03-04):

Single axis drive gear resize

SashaBrooke, 2025-03-04:
**Hardware issue description:**
May want to resize the drive gear so that it doesn't stick out from under the top plate. It was supposed to be this way initially but by mistake was made too large.

<p align="middle">
  <kbd>
    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
  </kbd>
</p>

joeyboy2023, 2025-04-26:
Opted to resize top plate instead.
Easier fix in CAD and we needed more space for mounting various boards (raspberry pi pico, motor controller board etc.)

Closed 2025-04-26.

Thread 46 (2025-03-30):

M30 thread test print

SashaBrooke, 2025-03-30:
**Hardware request description:**
@joeyboy2023 to model and print samples of internal and external M30 thread. This should be done with and without supports to determine the best way to print the axle shaft and bottom plate for the single axis test jig.

SashaBrooke, 2025-04-04:
Apparently shouldn't require supports

SashaBrooke, 2025-04-04:
Test prints should include face offsets and filleting of thread peaks and valleys. May be worth using the test prints to check fitment and determining the best combination of these factors to ensure the Axle Shaft and Bottom Plate mate correctly in the Single Axis Test Jig.

SashaBrooke, 2025-04-15:
Test print with no face offset complete - far too tight.

joeyboy2023, 2025-04-19:
Test prints completed:
0mm offset = too tight
0.1mm offset = too tight
0.1mm offset + fillet = too tight with printing error, once corrected was a nice fit with little resistance and play
0.15mm offset + fillet = no resistance but a bit too much play

Closed 2025-04-19.

Thread 47 (2025-03-30):

Single axis test jig top plate redesign - PCB mounting

SashaBrooke, 2025-03-30:
**Hardware request description:**
Top plate needs to have mounting standoffs added to provide a way of mounting the control system microcontroller and motor driver board PCBs. Theoretically are not necessary (could just drill holes) but good practice and a similar design will be needed in the final prototype anyway.

joeyboy2023, 2025-04-05:
PCB mount holes were all similar as measured to imported CAD file.
Raspberry Pi was similar longwise, the holes on the short side had approx. 0.2mm variation when comparing imported CAD file to physical board.

**Action:** Slots will need to be made for the holes on the short side

joeyboy2023, 2025-04-19:
Also needs mounting holes for the Raspberry Pi debug probe board

SashaBrooke, 2025-04-25:
Debug probe will be added in a future rework.

SashaBrooke, 2025-04-25:
Need to investigate possible mounting issue - motor driver board standoffs don't seem to line up with holes on the PCB.

*Left pair of standoffs (below)*

<kbd>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</kbd>

SashaBrooke, 2025-04-25:
Also add fasteners once above concern in resolved

Closed 2025-04-27.

Thread 48 (2025-04-04):

Setup Raspberry Pi AI Hat+

SashaBrooke, 2025-04-04:
**Issue description:**
Complete assembly and initial setup of Raspberry Pi AI Hat+. Perhaps get some of the Python example pipelines running so that we can make a call whether to develop the Gimbal Control Module in Python or C/C++. Also test EO/IR camera hardware.

SashaBrooke, 2025-04-21:
Hardware setup + basic python pipeline working. Will start with developing the gimbal control in Python (for Joe) but may decide to move to C/C++ later if more specific functionality is required.

Closed 2025-04-21.

Thread 49 (2025-04-05):

Prepare M30 threaded parts for Single Axis Test Jig

SashaBrooke, 2025-04-05:
**Hardware issue description:**
Redo face offsets and apply filleting to peaks and valleys of threaded parts for the Single Axis Test Jig before printed. Relies on results from test prints in #46.

SashaBrooke, 2025-04-15:
First print with 0 face offset completed - far too tight.

joeyboy2023, 2025-04-19:
Post testing we will try initial print with -0.11mm offset + fillet.
Results pending

Closed 2025-04-30.

Thread 50 (2025-04-08):

3D printing extrusion error

joeyboy2023, 2025-04-08:
3D printer is having errors during extrusion - there is filament leaking between the hot end and nozzle

joeyboy2023, 2025-04-08:
Will require disassembly of hot end, re-cut threads with tap and die, ensure proper fitment.
Will need to tighten the assembly while everything is still hot --> this will ensure a good fit

SashaBrooke, 2025-04-08:
First issue woop woop 🎉🎉🎉🎉🎉🎉

SashaBrooke, 2025-04-15:
Based on last couple prints seems resolved for now.

Closed 2025-04-15.

Thread 51 (2025-04-08):

3D printing extrusion gears jammed

joeyboy2023, 2025-04-08:
Gears on 3D printing extrusion head were jamming, causing printing error - unable to feed filament down to hot end

SashaBrooke, 2025-04-08:
He's that quick 😎

Closed 2025-04-08.

Thread 52 (2025-04-15):

Investigate control system RTOS

SashaBrooke, 2025-04-15:
**Feature description:**
Investigate possibly using FreeRTOS for the control system on the Raspberry Pi Pico. This should simplify sensor input and help either modularity. Should probably be done before reworking any of the existing system in case that leads to useless work.

**Resources:**
[FreeRTOS on Raspberry Pi Pico basic tutorial](https://m.youtube.com/watch?v=5pUY7xVE2gU&pp=ygUZUnRvcyBvbiByYXNwYmVycnkgcGlucGljbw%3D%3D)

Thread 54 (2025-04-21):

Raspberry Pi 5 desk setup

SashaBrooke, 2025-04-21:
**Hardware request description:**
Want a desk setup to mount the Raspberry Pi 5 on with a DC fan. Optional but desirable is also including a mount for the Raspberry Pi Camera Module 3.

Could be a bit of fun to design.

*##### **IMPORTANT:** Work off separate feature branch (already setup [here](https://github.com/SashaBrooke/OhPossum/tree/raspi-desktop-jig)). #####*

**Reference photo:**
*Left: DC fan, Middle: Raspberry Pi 5 (with AI HAT+), Right: Raspberry Pi Camera Module 3 (attached)
<kbd>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</kbd>

**Initial design drawing:**
Just an initial design - more than welcome to change/update.
<kbd>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</kbd>

**Additional resources:**
[Raspberry Pi 5 CAD Model](https://grabcad.com/library/raspberry-pi-5-2)
[Raspberry Pi Camera Module 3 CAD Model](https://grabcad.com/library/raspberry-pi-camera-module-v3-2)

SashaBrooke, 2025-04-25:
Version 1 finalised - will be printed (@joeyboy2023 ???)

SashaBrooke, 2025-05-20:
Printed by @SMBrooke

<kbd>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</kbd>

<kbd>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</kbd>

Closed 2025-05-20.

Thread 55 (2025-04-28):

Enable Hailo post-process in GCB test program

SashaBrooke, 2025-04-28:
**Feature description:**
Need to work out how to provide the flags to get the meson build system to build with Hailo post-processing support.

SashaBrooke, 2025-04-28:
**Possibly useful resources:**
[Raspberry Pi camera software documentation](https://www.raspberrypi.com/documentation/computers/camera_software.html)
[Rpicam-apps GitHub repo](https://github.com/raspberrypi/rpicam-apps)

Closed 2025-04-30.

Thread 58 (2025-04-30):

Single axis test jig print/re-print

SashaBrooke, 2025-04-30:
**Manufacturing request:**
Print or re-print any remaining parts for the Single Axis Test Jig. I believe this is our progress so far.

Printed:
- Top bearing retainer
- Axle shaft
- Drive gear (wonky threaded insert but should be ok)

Needs printing:
- Top plate (needs reprint - updated model and issues with initial print layer shift)
- Bottom plate (initial print)

Thread 63 (2025-06-29):

Minimise single axis footprint (height)

joeyboy2023, 2025-06-29:
Decisions:
- We want to minimise the height of the single axis ahead of the secondary axis design
- We are going to use the smaller slip ring
- Current design relies on larger slip ring so the previous decision will have flow on effects

Actions:
- Sink bearing interface below top plate (into bottom plate)
- Bottom bearing to rest sunk section of top plate (assuming new top plate will be printed upside down)
- Internal gears on bottom plate with a smaller drive gear connected to the motor
- Redesign axle shaft - reduced diameter slip ring
- Reduce thread height in the bottom plate
- Potentially shrink the height of the top bearing retainer - minimising height above top plate

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
