SashaBrooke/OhPossum/(commit log)

2024-11-13 Add datasheet for NEMA17 Stepper Motor
2024-11-20 Began work on initial prototype and DC motor test jig
    [AS5600 v1.step.SLDPRT, Assembly.rev1.SLDASM, Base.rev1.SLDPRT, Cradle Base.rev1.SLDPRT, Motor Mounting Plate.rev1.SLDPRT, Motor Testing Assembly.rev1.SLDASM, Motor Testing Base.rev1.SLDPRT, Motor Testing Flag.rev1.SLDPRT]
2024-12-01 First full revision of motor/decoder jig
    Made changes to the direction flag, revised fits and tolerances for holes (for mounting on shafts and for grub screws)
    [Encoder Mounting Plate.SLDPRT, Encoder Mounting Plate.rev1.STL, Encoder magnet cap.rev1.SLDPRT, Encoder test assem.rev1.SLDASM, Motor Mounting Plate.rev1.SLDPRT, Motor Mounting Plate.rev1.STL, Motor Testing Assembly.rev1.SLDASM, Motor Testing Base.rev1.SLDPRT]
2024-12-01 First full revision of motor/encoder jig
    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
    [Encoder Mounting Plate.SLDPRT, Encoder Mounting Plate.rev1.STL, Encoder magnet cap.rev1.SLDPRT, Encoder test assem.rev1.SLDASM, Motor Mounting Plate.rev1.SLDPRT, Motor Mounting Plate.rev1.STL, Motor Testing Assembly.rev1.SLDASM, Motor Testing Base.rev1.SLDPRT]
2024-12-01 Add Raspberry Pi Pico C/C++ SDK as submodule
2024-12-01 Updated encoder model and encoder mounting plate
    The online CAD model for the encoder differed greatly in dimensions from the encoder for received in the mail. Custom model was created of the encoder we received, along with an updated mounting plate
    [Ebay Encoder 1.rev1.SLDPRT, Encoder Mounting Plate.rev2.SLDPRT, Encoder test assem.rev2.SLDASM]
2024-12-01 Test repeating timer module and Pico build configuration
2024-12-02 Encoder magnet cap dimensions updated
    Received magnet for encoder in the mail, updated model with actual dimensions (replacing the ones found online)
    [Encoder Mounting Plate.rev2.STL, Encoder magnet cap.rev1.SLDPRT, Encoder magnet cap.rev1.STL]
2024-12-02 Implement raw angle reading functionality for AS5600 Magnetic Encoder
2024-12-02 Move encoder raw angle read into timer-based callback
2024-12-03 Implement basic PID controller with initial testing for simple position control
2024-12-04 Restructure Pico codebase as per CMake examples
2024-12-04 Begin implementation of AS5600 C library for RP Pico
2024-12-10 Add PWM response to PID controller
2024-12-10 Fix PWM setup and begin benchtop tuning
2024-12-11 Updated motor test jig
    Includes new assembly model for 3d printing use. Needs to have file types converted for slicing
    [Encoder Mounting Plate.rev1.STL, Encoder test assem.rev2.SLDASM, Motor Testing Assembly.rev1.SLDASM, Motor Testing Flag and Magnet Cap COMBO.rev3.SLDPRT]
2024-12-12 Interate serial input into controls loop, implement circular PID error and update controls loop frequency
2024-12-12 Fix incorrect PID alternating direction and PID wrapping errors
2024-12-13 Update pico-sdk to use latest commit in develop branch
    Attempt to fix big with repeating timer stopping after interrupts are
    disabled and re-enabled.
2024-12-13 Implement timer and interrupt deactivation/reactivation (prereq for flashing)
2024-12-24 Implement saving gimbal control gains to rpi pico flash
2025-01-02 Implement additional serial gimbal control commands
    Removed 'gimbal-mode' command in favour of safer (although less-modular)
    individual mode change commands.
    New commands:
    * help - show available commands
    * config-read - display the current gimbal configuration
    * config-save - save the current gimbal configuration
    * gimbal-read - display the currect state of the gimbal
    * gimbal-free - set the gimbal to free mode
    * gimbal-arm - arm the gimbal and set initial pan and tilt (TODO)
    setpoints
    * gimbal-stream - enable or disable gimbal streaming
    * gimbal-streamrate - set the gimbal stream rate
    * gimbal-serialno - set the gimbal serial number (limited to uint8
    values)
    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
2025-01-02 Fix serial command numeric value input parsing issue (#1)
    The bug was caused by atoi() returning 0 for non-integer inputs, causing
    error checks to treat non-numeric inputs as a valid case (e.g. 0 is
    valid for a boolean integer check).
    To resolve:
    - Use more robust parsing method (strtol/strtof) to handle invalid
    inputs and ensure proper behaviour.
    - Add additional check for empty inputs to ensure a value is provided
    (or trigger error appropriate error message).
2025-01-05 Add documentation for PID controller
2025-01-05 Include licensing information for PID controller implementation
2025-01-05 Credit Philip Salmony for PID starting implementation
2025-01-09 Update PID source file documentation brief to be more concise
    Leave details in header file.
2025-01-09 Add documentation for AS5600 magnetic encoder library
2025-01-12 Implement default gimbal configuration loading (#8)
    - Gimbal serial number and PID controller parameters are set using
    default values if there is no saved configuration to load
    - XOR checksum is used to validate/check for the precense of a saved
    configuration
2025-01-13 Increase resolution of sample time display
    Was previously not showing enough decimal places to actually see a non-zero sample time.
2025-01-13 Implement PID parameter modification via the serial command interface (#3) - Added individual commands for modifying PID gains, filter coefficients, and limits (e.g. `pan-pid-kp`) - Added a command t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
2025-01-14 Fix erroneous saved config after changing PID (#3)
    Change gimbal state to unsaved configuration when PID parameters are modified.
2025-01-14 Implement specific packet streaming (#11) Supported packets: - `positionStream` (pan/tilt) - `pidStream` (pan/tilt) - `motorStream` (pan/tilt)
    Implementation:
    - Added stream flags to gimbal state structure
    - Flags default to false on gimbal startup (user must manually setup
    which packets they want to stream)
2025-01-20 Add commands to select specific stream packets (#11) New `stream` commands: - `stream-<axis>-pos` to stream encoder position and setpoint (when armed) - `stream-<axis>-pid` to stream PID parameters (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
2025-01-23 Add axis soft limits to gimbal state (#9) - Add soft limits as members variables in the gimbal state structure - Introduce a sentinel value as the default value for axis soft limits that signifies be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
2025-01-23 Add ability to reset PID state parameters
2025-01-23 Ammend omission of PID output from state reset
2025-01-23 Ammend incorrect PID parameter reset
    - Mistakenly reset the upper output limit instead of output
2025-01-24 Improved Base
    [Aluminium Shaft.SLDPRT, Assembly.rev1.SLDASM, Base Assembly.rev1.SLDASM, Base Lid.rev1.SLDPRT, Base gear.rev1.SLDPRT, Base.rev1.SLDPRT, Base.rev2.SLDPRT, Motor Testing Assembly.rev1.SLDASM]
2025-01-30 First pass at single axis bottom plate (#4) Key features: - Printed thread to screw axle shaft into - Slot in thread for slipring cables to go through - Hole in outer wall for cables to go through
    [BottomPlate v3.f3d]
2025-01-30 First pass at single axis axle shaft (#4) Key features: - Printed thread to insert into bottom plate - Slot in thread for slipring wires to go through - Hollow center to allow space for slipring - Ca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
    [Initial axle design v1.f3d]
2025-01-30 Implement axis setpoint setting soft limit error checking (#23) - Except for the homing sequence, checks whether the current position is within the axis soft limits before arming - In `<axis>-setpos=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
2025-02-01 Axle shaft v2 Features: - Top slipring hole - Raised hole for encoder magnet
    [Initial axle design v1.f3d, Initial axle design v2.f3d]
2025-02-01 Update gitignore to not track lock files - Add lock file entry to gitignore - Remove already tracked indexes
2025-02-02 Increase axle shaft slipring holes
    [Initial axle design v2.f3d, Initial axle design v3.f3d]
2025-02-03 Improve bottom plate mounting mechanism - Add four mounting feet with M5 fastener holes - Increase height of thread mount - Increase height of walls - Change cable hole to circular rather than rectan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
    [BottomPlate v3.f3d, BottomPlate v4.f3d]
2025-02-04 Include 6806ZZ bearing model from JTEKT (Koyo)
    [6806ZZ v1.f3d]
2025-02-04 Rotate imported model to horizontal plane
    [6806ZZ v1.f3d, 6806ZZ v2.f3d]
2025-02-04 First version of top bearing retainer - Designed to hold a 6806ZZ bearing - Three evenly spaced M3 holes for clamping
    [Top bearing retainer v1.f3d]
2025-02-04 First version of gimbal top plate - Include circular walled section to hold double bearing setup - Include ten M3 holes for attaching cradle arms in future - Include three M3 holes for attaching top 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
    [TopPlate v1.f3d]
2025-02-05 Model LMP-30A slipring
    [LMP-30A v1.f3d]
2025-02-05 Rotate axle shaft thread to match bottom plate
    [Initial axle design v3.f3d, Initial axle design v5.f3d]
2025-02-05 Create single axis test jig assembly (#4) - Thread axle shaft into bottom plate - Define join motion (slide + twist) and limits
    [SingleAxisTestJig v3.f3z]
2025-02-07 Use more detailed NEMA 17 Stepper Motor datasheet
2025-02-07 Add 6806 ZZ Bearing datasheet
2025-02-07 Add AS5600 Magnetic Rotary Encoder datasheet
2025-02-08 Model 6806ZZ bearing as rigid group
    [6806ZZ v2.f3d, 6806ZZ v3.f3d]
2025-02-08 Extend bearing dividing ring radius by 1mm
    Serves to add extra support and reduce risk of mechanical failure if 3D print becomes weak
    [Initial axle design v5.f3d, Initial axle design v6.f3d]
2025-02-08 Extend bearing clamping surface radius by 1mm
    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
    [TopPlate v1.f3d, TopPlate v2.f3d]
2025-02-08 Clamped top plate and bearings
    [SingleAxisTestJig v3.f3z, SingleAxisTestJig v4.f3z]
2025-02-09 Encoder Fusion file
    [AS5600 v1.step.SLDPRT, Aluminium Shaft.SLDPRT, Assembly.rev1.SLDASM, Base Assembly.rev1.SLDASM, Base Lid.rev1.SLDPRT, Base gear.rev1.SLDPRT, Base.rev1.SLDPRT, Base.rev2.SLDPRT]
2025-02-09 Archive specific ebay encoder in favour of generic model
    [AS5600 v1.f3d, AS5600_ebay v1.f3d, Encoder v1.f3d]
2025-02-09 Add pan slipring
    [SingleAxisTestJig v4.f3z, SingleAxisTestJig v5.f3z]
2025-02-09 Add top bearing mounting cap
    [Top bearing retainer v1.f3d, Top bearing retainer v2.f3d]
2025-02-09 Update top bearing retainer model
    [SingleAxisTestJig v5.f3z, SingleAxisTestJig v6.f3z]
2025-02-09 Add AS5600 pan encoder
    [SingleAxisTestJig v6.f3z, SingleAxisTestJig v7.f3z]
2025-02-09 Add M3 fastener/nut models
    [M3 Cup Head Bolts（M3X6） v1.f3d, M3x1.8mm Hex Nut v1.f3d]
2025-02-09 Assemble with M3 fasteners
    [SingleAxisTestJig v7.f3z, SingleAxisTestJig v8.f3z]
2025-02-09 Create and add encoder magnet model
    [Encoder magnet v1.f3d, SingleAxisTestJig v8.f3z, SingleAxisTestJig v9.f3z]
2025-02-10 Small DC motor - Fusion
    [Small Motor.f3d, Small Motor.rev1.STEP]
2025-02-10 Move to plane
    [Small Motor v2.f3d, Small Motor.f3d]
2025-02-11 Add motor mounting holes
    [SingleAxisTestJig v10.f3z, SingleAxisTestJig v9.f3z, TopPlate v2.f3d, TopPlate v3.f3d]
2025-02-11 Mount pan axis motor
    [SingleAxisTestJig v10.f3z, SingleAxisTestJig v11.f3z]
2025-02-12 Apply face offsets for fastener holes (printing preparation)
    [Top bearing retainer v2.f3d, Top bearing retainer v3.f3d]
2025-02-17 Apply face offsets for first print
    [TopPlate v3.f3d, TopPlate v5.f3d]
2025-02-18 Apply face offsets for initial print - Fastener holes - Thread
    [BottomPlate v4.f3d, BottomPlate v5.f3d, SingleAxisTestJig v12.f3z, SingleAxisTestJig v13.f3z]
2025-02-18 Apply face offsets for initial print - Encoder magnet hole - Slipring hole - Thread - Bearing surfaces
    [Initial axle design v6.f3d, Initial axle design v7.f3d, SingleAxisTestJig v13.f3z, SingleAxisTestJig v14.f3z]
2025-02-19 Revert to latest action in timeline
    [BottomPlate v5.f3d, BottomPlate v6.f3d]
2025-02-20 Model drive gear
    [Drive gear v1.f3d]
2025-02-20 Embed drive gear in bottom plate
    [BottomPlate v6.f3d, BottomPlate v8.f3d]
2025-02-20 Add/update new gear components
    [SingleAxisTestJig v14.f3z]
2025-02-21 Apply face offset to make room for motor mounting fasteners
    [Drive gear v1.f3d, Drive gear v2.f3d]
2025-02-21 Make mounting holes deeper for accurate modelling (#33)
    [Small Motor v2.f3d, Small Motor v3.f3d]
2025-02-23 Increase mounting sleeve length to make room for limit switches
    [Drive gear v2.f3d, Drive gear v3.f3d]
2025-02-23 Create Omron SS-5GL2 v2.f3d
    [Omron SS-5GL2 v2.f3d]
2025-02-23 Add limit switch mounting holes
    [TopPlate v5.f3d, TopPlate v6.f3d]
2025-02-23 Update drive gear grub screw holes to M2.5
    [Drive gear v3.f3d, Drive gear v4.f3d]
2025-02-23 Add extra material for drive gear grub screw threaded insert
    [Drive gear v4.f3d, Drive gear v5.f3d]
2025-02-25 Offset cradle mounting holes for extra strength
    [TopPlate v6.f3d, TopPlate v7.f3d]
2025-02-25 Fixed cached joint error
    [TopPlate v7.f3d, TopPlate v8.f3d]
2025-02-25 Increase grub screw hole size for printing
    [Drive gear v5.f3d, Drive gear v6.f3d]
2025-02-25 Re-export after exporting print file
    [TopPlate v8.f3d]
2025-02-25 Export initial print run files
    [Drive gear v6.stl, TopPlate v8.stl]
2025-02-25 Increase size of top bearing retainer fastener holes for print
    [TopPlate v8.f3d, TopPlate v9.f3d]
2025-02-25 Export updated top plate print file
    [TopPlate v8.stl, TopPlate v9.stl]
2025-02-28 Add hard limit tabs to bottom plate
    [BottomPlate v8.f3d, BottomPlate v9.f3d]
2025-03-01 Update to set soft limits only after successful homing (#38)
2025-03-02 Fix PID error calculation result and ignoring limits (#28, #30) - Include rotary utilities library to handle error calculation with and without soft limits - Add a separate constant that will be set 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
2025-03-02 Begin recording relationship between modelled and printed hole sizes
    [Printed Hole Size Dictionary.xlsx]
2025-03-02 Update holes for possible re-print
    [TopPlate v10.f3d, TopPlate v10.stl, TopPlate v9.f3d, TopPlate v9.stl]
2025-03-04 Attach soft limit switches (#35, #39)
    [M2.5 Hex Screws (Various Lengths) v3.f3d, M2.5x14mm Cup Head Bolt v2.f3z, M2.5x2mm Hex Nut v2.f3d, M2.5x2mm Standoff v1.f3d, Omron SS-5GL2 v2.f3d, TopPlate v10.f3d, TopPlate v11.f3d]
2025-03-07 Implement 'move back into limits' functionality (#40)
    Gimbal will drive at full PID output (TBD) back towards the nearest soft limit when outside limits.
2025-03-08 Update drive gear holes for re-print
    [Drive gear v6.f3d, Drive gear v7.f3d]
2025-03-08 Add fillets to axle shaft (#36)
    [Initial axle design v7.f3d, Initial axle design v9.f3d]
2025-03-08 Add new M3 hole entry
    [Printed Hole Size Dictionary.xlsx]
2025-03-08 Update models, attach motor, and fix joint errors
    [M2 x 0.4mm Thread 10mm LONG SOCKET HEAD CAP SCREW v1.f3d]
2025-03-09 Update holes for printing
    [Top bearing retainer v4.f3d, Top bearing retainer v5.f3d]
2025-03-09 Add fillets to overhanging tabs (#36)
    [BottomPlate v10.f3d, BottomPlate v9.f3d]
2025-03-10 Bottom plate - grub screw hole & fillets
    [BottomPlate v10.f3d, BottomPlate v12.f3d]
2025-03-10 Files for printing
    [BottomPlate v13.stl, Drive gear v6.stl, Initial axle design v10.stl, Top bearing retainer v5.stl, TopPlate v10.stl]
2025-03-10 Add new M3 threaded insert and encoder magnet hole entries
    [Printed Hole Size Dictionary.xlsx]
2025-03-10 Add locating grub screw and update model
    [Initial axle design v10.f3d, Initial axle design v9.f3d, M3 x 0.5mm Thread 18mm LONG SOCKET HEAD CAP SCREW v1.f3d]
2025-03-10 Export remaining print files
    [Drive gear v7.stl, TopPlate v11.stl]
2025-03-10 Export model for edrawings viewing
    [6806ZZ Ball.ipt, 6806ZZ Inner ring.ipt, 6806ZZ Outer ring.ipt, 6806ZZ Shield.ipt, 6806ZZ v3.iam, 6806ZZ v3_1.iam, AS5600 v2.ipt, Arm.ipt]
2025-05-20 feat(desktop jig): Upload raspberry pi 5 model
    Sourced from GrabCAD
    [1.1 part 1 metal pin.SLDPRT, 2.0_PIN_HEADER.SLDPRT, 2.2 part 2 with combine.SLDPRT, 2xUSB_2.0_PORT.SLDPRT, 2xUSB_3.0_PORT.SLDPRT, 3.0_PIN_HEADER_10.SLDPRT, 3.3 plastic.SLDPRT, 9FD77_D9WHV.SLDPRT]
2025-05-20 docs(desktop jig): Add 04020VA DC fan datasheet
2025-05-20 feat(desktop jig): Add fan, camera, mesh and roof
    [04020VA.sldprt, 1.1 part 1 metal pin.SLDPRT, 2.0_PIN_HEADER.SLDPRT, 2.2 part 2 with combine.SLDPRT, 2xUSB_2.0_PORT.SLDPRT, 2xUSB_3.0_PORT.SLDPRT, 3.0_PIN_HEADER_10.SLDPRT, 3.3 plastic.SLDPRT]
2025-05-20 feat(desktop jig): Add holes and offsets
    [Mesh.SLDPRT, Raspberry Pi Desk Jig Model.SLDPRT, Roof.SLDPRT]
2025-05-20 feat(desktop jig): Upload final print and assembly images
2026-07-25 chore(hardware): Re-export up to date models
    [04020VA.sldprt, 0603 Blue.iam, 1x6 Male Pin Header.iam, 6806ZZ Ball.ipt, 6806ZZ Inner ring.ipt, 6806ZZ Outer ring.ipt, 6806ZZ Shield.ipt, 6806ZZ v3.f3d]
2026-08-06 chore(repo): Move towards hardware-specific repo
    [04020VA.sldprt, 0603 Blue.iam, 1x6 Male Pin Header.iam, 6806ZZ Ball.ipt, 6806ZZ Inner ring.ipt, 6806ZZ Outer ring.ipt, 6806ZZ Shield.ipt, 6806ZZ v3.f3d]
