SashaBrooke/OhPossum/models/raspi_desktop_jig/final-assembly.jpeg

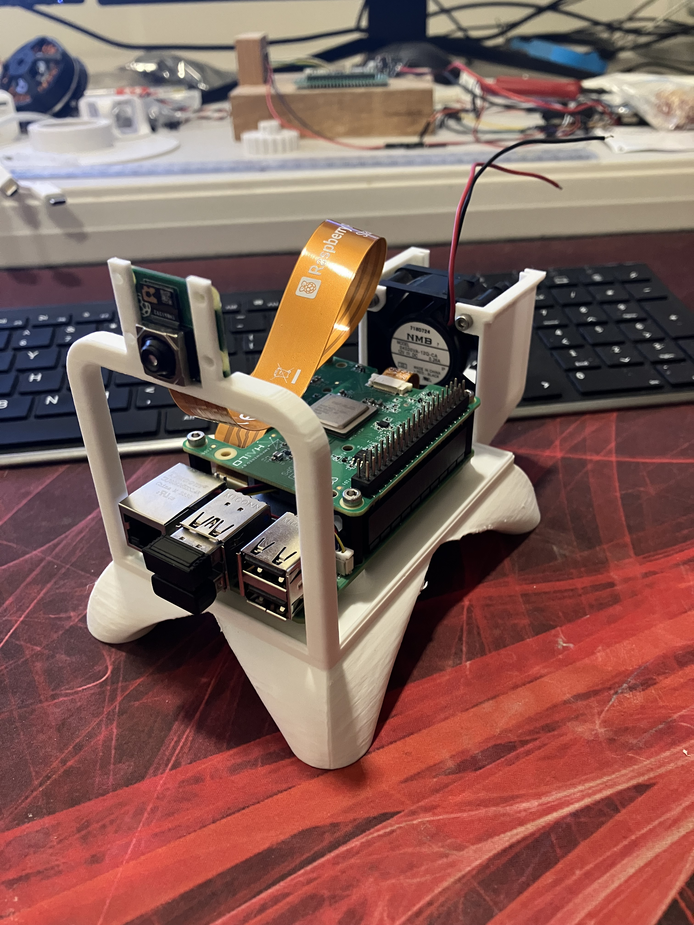
models/raspi_desktop_jig/final-assembly.jpeg
