SashaBrooke/OhPossum/models/raspi_desktop_jig/final-print.jpeg

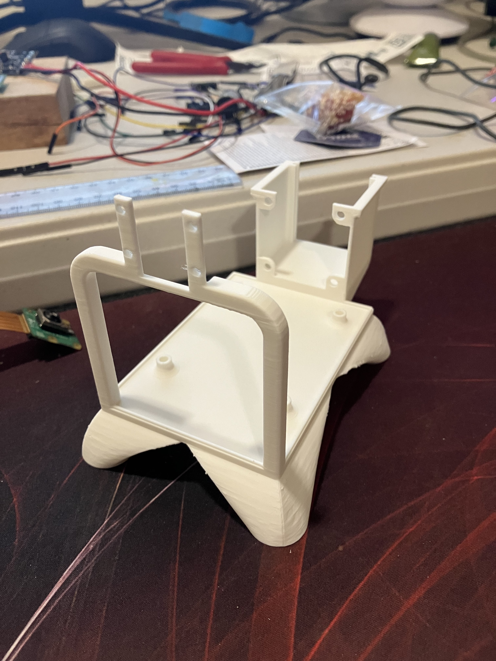
models/raspi_desktop_jig/final-print.jpeg
